KarlTorp/Tiny-VA-Meter/schematics/Tiny VA Meter picture schematics.png

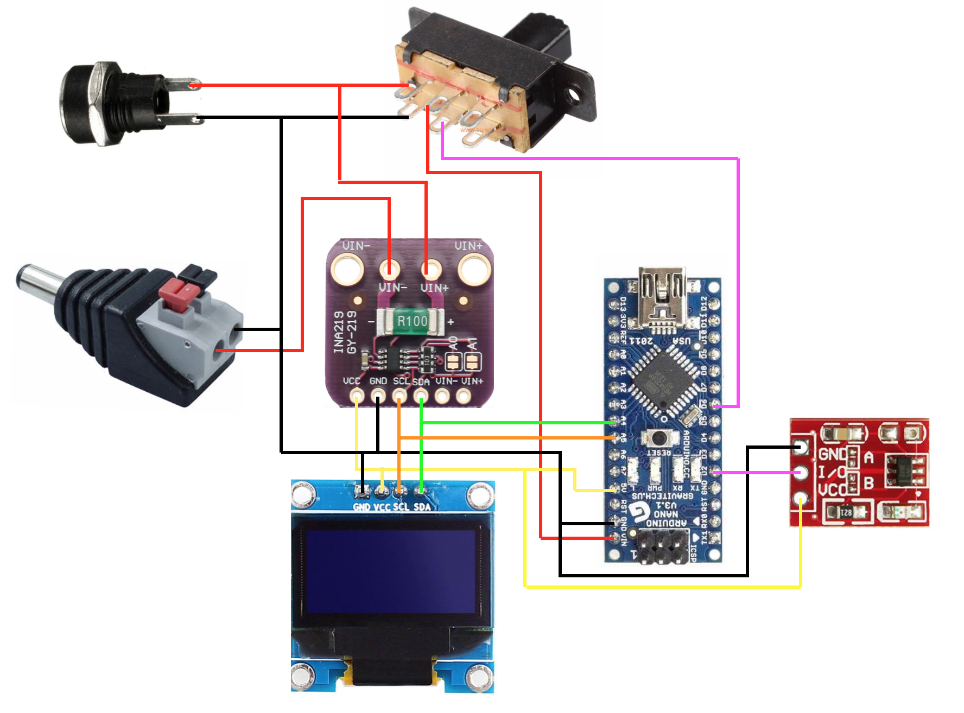
schematics/Tiny VA Meter picture schematics.png
