KarlTorp/Tiny-VA-Meter/schematics/Tiny VA Meter schematic.pdf

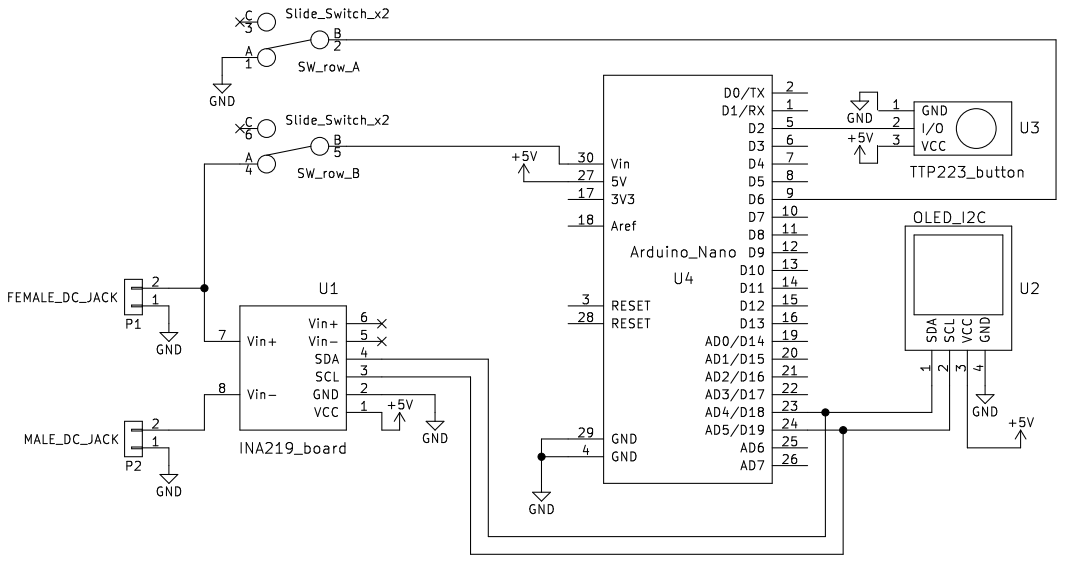
[picture p2: page 1]
