KarlTorp/Tiny-VA-Meter/(commit log)

2019-08-05 Added Initial menu and button handling
2020-05-05 Update Tiny-VA-Meter.ino
    Updated to 128x64 Display. Added serial commands for sensor range and help text.
2020-05-06 Added BOM and schematic
2020-05-14 Display correct sensor voltage range
    [Tiny-VA-Meter.ino]
2020-05-15 Fix schematics name
2020-05-15 clean up arduino code
2020-05-19 Added USB and Power Jack icons
2020-06-05 Added link to instructables & picture schematics
2020-06-08 Replaced Adafruit driver with ArduinoINA219
    [Tiny-VA-Meter.ino]
2020-06-08 Settings for volt & amp range + averaging
2020-06-09 Created class for button & cleanup
2020-06-10 Use EEPROM.update and updated button read
2020-06-14 Fixed feature disable and simplified short press handler
    [FlashMem.h, Tiny-VA-Meter.ino]
2020-06-14 Move schematics and update readme
